ICE-V-Wireless/ICE-V_MfgTest/Hardware/README.md

#Hardware
These directories contain board designs necessary to support the ICE-V Wireless
manufacturing test.
