ICE-V-Wireless/ICE-V_MfgTest/Gateware/README.md

#Gateware
These directories contain gateware necessary to support the ICE-V Wireless
manufacturing test.
