ICE-V-Wireless/ICE-V_MfgTest/Hardware/ICE-V_Test/ICE-V_Test.step

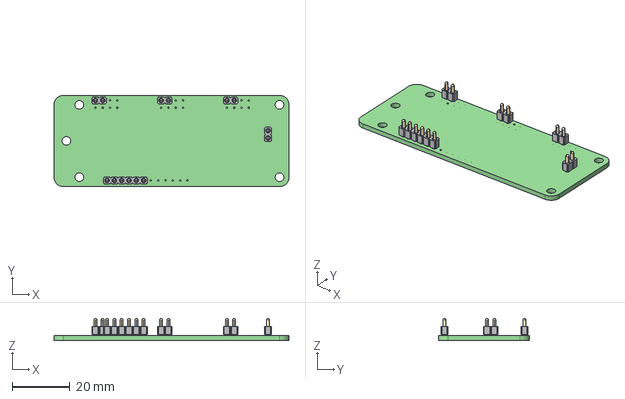
[picture p1: CAD file, 2022-08-24]
Hardware/ICE-V_Test/ICE-V_Test.step
81.7 x 31.8 x 7.75 mm
ICE-V_Test PCB
