ICE-V-Wireless/ICE-V_MfgTest/python/run_test.py

#!/usr/bin/env python3
# Script for the ICE-V Wireless manufacturing testing. This program will
# execute a single pass of the test and firmware load process.

import getopt
import sys
from subprocess import Popen, PIPE, STDOUT, TimeoutExpired
import serial
import re
import time
from os.path import exists
from serial.tools import list_ports
import queue
import threading

# get ESP32C3 serial port
def get_C3_port():
    port = list(list_ports.grep("303a:1001"))
    if len(port) > 0:
        return port[0][0]
    else:
        return 'none'

# strips ANSI escape sequences from received text
def escape_ansi(line):
    ansi_escape =re.compile(r'(\x9B|\x1B\[)[0-?]*[ -\/]*[@-~]')
    return ansi_escape.sub('', line)

# gets output from subprocess into queue for analysis
def output_reader(proc, outq):
    for line in iter(proc.stdout.readline, b''):
        outq.put(line.decode('utf-8'))
    outq.put("Terminated ")
    
# flashes a full set of firmware to the ESP32C3, including SPIFFS
def flash_esp32(port, directory, main, tag, v):
    # run local copy of esptool directly
    cmd = ['../esptool/esptool.py', '-p', port, \
           '-b', '460800', '--before',  'default_reset', '--after', 'hard_reset', \
           '--chip', 'esp32c3', '--no-stub', 'write_flash', '--flash_mode', 'dio', \
           '--flash_size', 'detect', '--flash_freq', '80m', '0x0', \
            directory + '/bootloader.bin', '0x8000', \
            directory + '/partition-table.bin', '0x10000', \
            directory + '/' + main + '.bin',  '0x110000', \
            directory + '/storage.bin']
    p = Popen(cmd, stdout=PIPE, stdin=PIPE, stderr=STDOUT)

    # handle output
    if 0:
        # original batch approach
        output = p.communicate()[0]
        output = output.decode('UTF-8')

        if v:
            print(output)
            
        if "verified" in output:
            print(tag, "Flash Succeeded")
            return 0
        elif "fatal" in output:
            print(tag, "Flash Failed")
            return 1
        else:
            print(tag, "Flash Unknown result")
            return 2
    else:
        # realtime approach needs queues and threads
        result = 2
        q = queue.Queue()
        t = threading.Thread(target=output_reader, args=(p, q))
        t.start()
        time.sleep(0.2)
        running = True
        linectr = 0
        vctr = 0
        fail = False
        while running:
            line = q.get(block=True)
            
            # strip newline
            line = line[:-1]
            linectr = linectr + 1

            # verbose or progress
            if v:
                print(line)
            elif linectr%36==0:
                print(".", end = '')
                sys.stdout.flush()
                
            if "verified" in line:
                vctr = vctr + 1
            elif "fatal" in line:
                fail = True
            elif "Terminated" in line:
                running = False
        t.join()

        print(" ")
        
        if fail:
            print("Flash failed")
            result = 1
        elif vctr == 4:
            print("Flash succeeded")
            result = 0
        else:
            print("Unknown flash result")
        
        return result
    
# run the process
def test_process(port, t, u, i, v):
    err = 0
    if t:
        # flash mfg test firmware
        print("Flashing Mfg Test Firmware...")
        ferr = flash_esp32(port, 'test_firmware', 'ICE-V_MfgTst', \
                           'Test Firmware', v)

        if ferr == False:
            # open up serial port and get test results
            print("Collecting Mfg Test Firmware Results")
            with serial.Serial(port) as tty:
                while True:
                    reply = tty.read_until()
                    rplystr = escape_ansi(reply.decode('utf-8'))
                    rplystr = rplystr.rstrip('\n')
                    rplystr = rplystr[:-1]
                    if "#TEST#" in rplystr:
                        print(rplystr)
                        if "Complete" in rplystr:
                            # test is done so bail out and close port
                            break
                    elif v:
                        print(rplystr)
                        
            # Report result
            if "PASS" in rplystr:
                print("Test Passed")
            elif "FAIL" in rplystr:
                print("Test Failed")
                err = 1
            else:
                print("Test Unknown result")
                err = 1
        else:
            print("Skipped Mfg Test")
        
    if u:
        # flash default end-user firmware
        print("Flashing End-User Firmware...")
        ferr = flash_esp32(port, 'ship_firmware', 'ICE-V_Wireless', \
                           'End-User Firmware', v)
    else:
        ferr = False
    
    if ferr == False and i:
        # try usb-serial command to check ID register
        print("Testing End-User Firmware ID...")
        cmd = ['../../ICE-V-Wireless/python/send_c3usb.py', '-r', '0']

        # Try 5x before giving up
        tries = 0
        ID = "0xb00f0001"
        while tries<5:
            p = Popen(cmd, stdout=PIPE, stdin=PIPE, stderr=STDOUT)

            output = p.communicate()[0]
            output = output.decode('UTF-8')
            output = output[:-1]
            print("Try ", tries, ":", output)
            if ID in output:
                break;
            tries = tries + 1
            time.sleep(0.2)
            
        if ID in output:
            print("USB ID command PASS")
        else:
            print("USB ID command FAIL")
            err = err + 1
            
    # all done
    return err

# usage text for command line
def usage():
    print(sys.argv[0], " [options] Execute Mfg Test & Flashing")
    print("  -h, --help              : this message")
    print("  -p, --port=<tty>        : usb tty of ESP32C3 (default /dev/ttyACM0)")
    print("  -t, --test              : only flash & report mfg test")
    print("  -u, --user              : only flash user firmware")
    print("  -i, --id                : only run ID test on user firmware")
    print("  -v, --verbose           : verbose progress")

# main entry
if __name__ == "__main__":
    try:
        opts, args = getopt.getopt(sys.argv[1:], \
            "hp:tfiuv", \
            ["help", "port=", "test", "user", "id", "verbose"])
    except getopt.GetoptError as err:
        # print help information and exit:
        print(err)  # will print something like "option -a not recognized"
        usage()
        sys.exit(2)

    # defaults
    port = get_C3_port()
    if(port == 'none'):
        print('No ESP32C3 attached')
        sys.exit(2)
    
    t = 1
    u = 1
    i = 1
    v = 0
    
    # scan thru options
    for o, a in opts:
        if o in ("-h", "--help"):
            usage()
            sys.exit()
        elif o in ("-p", "--port"):
            port = a
        elif o in ("-t", "--test"):
            f = 0
            i = 0
        elif o in ("-u", "--user"):
            t = 0
            i = 0
        elif o in ("-i", "--id"):
            t = 0
            u = 0
        elif o in ("-v", "--verbose"):
            v = 1
        else:
            assert False, "unhandled option"

    # check if tty port actually exists
    if exists(port) == False:
        print("Port", port, "does not exist")
        sys.exit(1)

    # run the test
    result = test_process(port, t, u, i, v)
    if result:
        print("Overall - FAIL")
    else:
        print("Overall - PASS")
    
    sys.exit(result)
    
