ICE-V-Wireless/ICE-V_MfgTest/Firmware/ice-v_mfgtest/main/wifi.c

/*
 * wifi.c - part of esp32c3_fpga. Set up pre-provisioned WiFi networking.
 * 04-06-22 E. Brombaugh
 */

#include <string.h>
#include "wifi.h"
#include "esp_event.h"
#include "esp_wifi.h"
#include "esp_wifi_default.h"
#include "esp_netif.h"
#include "nvs_flash.h"
#include "freertos/event_groups.h"
#include "lwip/err.h"
#include "lwip/sys.h"
#include "lwip/sockets.h"
#include "lwip/netdb.h"
#include "phy.h"
#include "credentials.h"
#include "esp_idf_version.h"

static const char *TAG = "wifi";

/******************************************************************************/
/* Basic WiFi connection                                                      */
/******************************************************************************/
static int s_active_interfaces = 0;
#if ESP_IDF_VERSION >= ESP_IDF_VERSION_VAL(5, 0, 0)
static SemaphoreHandle_t s_semph_get_ip_addrs;
#else
static xSemaphoreHandle s_semph_get_ip_addrs;
#endif
static esp_netif_t *s_example_esp_netif = NULL;

#if ESP_IDF_VERSION < ESP_IDF_VERSION_VAL(4, 4, 2)
// there's an include for this in V4.4.2 and beyond
extern void phy_bbpll_en_usb(bool en);
#endif

/* stuff that's usually in the menuconfig */
#define CONFIG_EXAMPLE_WIFI_SCAN_RSSI_THRESHOLD -127
#define EXAMPLE_WIFI_SCAN_METHOD WIFI_ALL_CHANNEL_SCAN
#define EXAMPLE_WIFI_SCAN_AUTH_MODE_THRESHOLD WIFI_AUTH_WPA2_PSK
#define EXAMPLE_WIFI_CONNECT_AP_SORT_METHOD WIFI_CONNECT_AP_BY_SIGNAL
#define NR_OF_IP_ADDRESSES_TO_WAIT_FOR (s_active_interfaces)

esp_netif_t *get_example_netif_from_desc(const char *desc)
{
    esp_netif_t *netif = NULL;
    char *expected_desc;
    asprintf(&expected_desc, "%s: %s", TAG, desc);
    while ((netif = esp_netif_next(netif)) != NULL) {
        if (strcmp(esp_netif_get_desc(netif), expected_desc) == 0) {
            free(expected_desc);
            return netif;
        }
    }
    free(expected_desc);
    return netif;
}

/**
 * @brief Checks the netif description if it contains specified prefix.
 * All netifs created withing common connect component are prefixed with the module TAG,
 * so it returns true if the specified netif is owned by this module
 */
static bool is_our_netif(const char *prefix, esp_netif_t *netif)
{
    return strncmp(prefix, esp_netif_get_desc(netif), strlen(prefix) - 1) == 0;
}

static esp_ip4_addr_t s_ip_addr;

static void on_got_ip(void *arg, esp_event_base_t event_base,
                      int32_t event_id, void *event_data)
{
    ip_event_got_ip_t *event = (ip_event_got_ip_t *)event_data;
    if (!is_our_netif(TAG, event->esp_netif)) {
        ESP_LOGW(TAG, "Got IPv4 from another interface \"%s\": ignored", esp_netif_get_desc(event->esp_netif));
        return;
    }
    ESP_LOGI(TAG, "Got IPv4 event: Interface \"%s\" address: " IPSTR, esp_netif_get_desc(event->esp_netif), IP2STR(&event->ip_info.ip));
    memcpy(&s_ip_addr, &event->ip_info.ip, sizeof(s_ip_addr));
    xSemaphoreGive(s_semph_get_ip_addrs);
}

static void on_wifi_disconnect(void *arg, esp_event_base_t event_base,
                               int32_t event_id, void *event_data)
{
    ESP_LOGI(TAG, "Wi-Fi disconnected, trying to reconnect...");
    esp_err_t err = esp_wifi_connect();
    if (err == ESP_ERR_WIFI_NOT_STARTED) {
        return;
    }
    ESP_ERROR_CHECK(err);
}

static esp_netif_t *wifi_start(void)
{
    char *desc;
    wifi_init_config_t cfg = WIFI_INIT_CONFIG_DEFAULT();
    ESP_ERROR_CHECK(esp_wifi_init(&cfg));

    esp_netif_inherent_config_t esp_netif_config = ESP_NETIF_INHERENT_DEFAULT_WIFI_STA();
    // Prefix the interface description with the module TAG
    // Warning: the interface desc is used in tests to capture actual connection details (IP, gw, mask)
    asprintf(&desc, "%s: %s", TAG, esp_netif_config.if_desc);
    esp_netif_config.if_desc = desc;
    esp_netif_config.route_prio = 128;
    esp_netif_t *netif = esp_netif_create_wifi(WIFI_IF_STA, &esp_netif_config);
    free(desc);
    esp_wifi_set_default_wifi_sta_handlers();

    ESP_ERROR_CHECK(esp_event_handler_register(WIFI_EVENT, WIFI_EVENT_STA_DISCONNECTED, &on_wifi_disconnect, NULL));
    ESP_ERROR_CHECK(esp_event_handler_register(IP_EVENT, IP_EVENT_STA_GOT_IP, &on_got_ip, NULL));

    ESP_ERROR_CHECK(esp_wifi_set_storage(WIFI_STORAGE_RAM));
    wifi_config_t wifi_config = {
        .sta = {
            .ssid = CONFIG_EXAMPLE_WIFI_SSID,
            .password = CONFIG_EXAMPLE_WIFI_PASSWORD,
            .scan_method = EXAMPLE_WIFI_SCAN_METHOD,
            .sort_method = EXAMPLE_WIFI_CONNECT_AP_SORT_METHOD,
            .threshold.rssi = CONFIG_EXAMPLE_WIFI_SCAN_RSSI_THRESHOLD,
            .threshold.authmode = EXAMPLE_WIFI_SCAN_AUTH_MODE_THRESHOLD,
        },
    };
	
	/* spritetm's workaround for auto USB disable - does this work? */
	ESP_LOGI(TAG, "Attempting to re-enable USB");
	phy_bbpll_en_usb(true);

    ESP_LOGI(TAG, "Connecting to %s...", wifi_config.sta.ssid);
    ESP_ERROR_CHECK(esp_wifi_set_mode(WIFI_MODE_STA));
    ESP_ERROR_CHECK(esp_wifi_set_config(WIFI_IF_STA, &wifi_config));
    ESP_ERROR_CHECK(esp_wifi_start());
	
    esp_wifi_connect();

    return netif;
}

static void wifi_stop(void)
{
    esp_netif_t *wifi_netif = get_example_netif_from_desc("sta");
    ESP_ERROR_CHECK(esp_event_handler_unregister(WIFI_EVENT, WIFI_EVENT_STA_DISCONNECTED, &on_wifi_disconnect));
    ESP_ERROR_CHECK(esp_event_handler_unregister(IP_EVENT, IP_EVENT_STA_GOT_IP, &on_got_ip));
    esp_err_t err = esp_wifi_stop();
    if (err == ESP_ERR_WIFI_NOT_INIT) {
        return;
    }
    ESP_ERROR_CHECK(err);
    ESP_ERROR_CHECK(esp_wifi_deinit());
    ESP_ERROR_CHECK(esp_wifi_clear_default_wifi_driver_and_handlers(wifi_netif));
    esp_netif_destroy(wifi_netif);
    s_example_esp_netif = NULL;
}

/* set up connection, Wi-Fi and/or Ethernet */
static void start(void)
{
    s_example_esp_netif = wifi_start();
    s_active_interfaces++;

    /* create semaphore if at least one interface is active */
    s_semph_get_ip_addrs = xSemaphoreCreateCounting(NR_OF_IP_ADDRESSES_TO_WAIT_FOR, 0);
}

/* tear down connection, release resources */
static void stop(void)
{
    wifi_stop();
}

esp_err_t example_connect(void)
{
    if (s_semph_get_ip_addrs != NULL) {
        return ESP_ERR_INVALID_STATE;
    }
    start();
    ESP_ERROR_CHECK(esp_register_shutdown_handler(&stop));
    ESP_LOGI(TAG, "Waiting for IP(s)");
    for (int i = 0; i < NR_OF_IP_ADDRESSES_TO_WAIT_FOR; ++i) {
		/* wait up to 10s then give up so test can complete */
        if(xSemaphoreTake(s_semph_get_ip_addrs, 10000/portTICK_PERIOD_MS) != pdTRUE)
		{
            ESP_LOGW(TAG, "Failed to connect");
			stop();
			return ESP_FAIL;
		}
    }
    // iterate over active interfaces, and print out IPs of "our" netifs
    esp_netif_t *netif = NULL;
    esp_netif_ip_info_t ip;
    for (int i = 0; i < esp_netif_get_nr_of_ifs(); ++i) {
        netif = esp_netif_next(netif);
        if (is_our_netif(TAG, netif)) {
            ESP_LOGI(TAG, "Connected to %s", esp_netif_get_desc(netif));
            ESP_ERROR_CHECK(esp_netif_get_ip_info(netif, &ip));

            ESP_LOGI(TAG, "- IPv4 address: " IPSTR, IP2STR(&ip.ip));
        }
    }
    return ESP_OK;
}

/*
 * initialize the WiFi interface
 */
esp_err_t wifi_init(void)
{
	esp_err_t ret;
	uint8_t cnt = 0;
	
	/* minimum stuff needed for IPV4 WiFi connection */
    ESP_ERROR_CHECK_WITHOUT_ABORT((ret = nvs_flash_init()));
	if(ret) cnt++;
	ESP_ERROR_CHECK_WITHOUT_ABORT((ret = esp_netif_init()));
	if(ret) cnt++;
	ESP_ERROR_CHECK_WITHOUT_ABORT((ret = esp_event_loop_create_default()));
	if(ret) cnt++;
	ESP_ERROR_CHECK_WITHOUT_ABORT((ret = example_connect()));
	if(ret) cnt++;
	
	return cnt == 0 ? ESP_OK : ESP_FAIL;
}

/*
 * get RSSI
 */
int8_t wifi_get_rssi(void)
{
	wifi_ap_record_t ap;
	esp_wifi_sta_get_ap_info(&ap);
	return ap.rssi;
}
