ICE-V-Wireless/ICE-V_MfgTest/Firmware/ice-v_mfgtest/main/adc_c3.c

/*
 * adc_c3.c - ADC driver for ESP32C3
 * 05-18-22 E. Brombaugh
 */
#include "adc_c3.h"
#include "esp_idf_version.h"

static const char* TAG = "adc_c3";

#if ESP_IDF_VERSION < ESP_IDF_VERSION_VAL(5, 0, 0)
/* Legacy ADC driver */
#include "driver/adc.h"
#include "esp_adc_cal.h"

#define ADC_C3_CHL ADC1_CHANNEL_3
#define ADC_EXAMPLE_CALI_SCHEME     ESP_ADC_CAL_VAL_EFUSE_TP
#define ADC_EXAMPLE_ATTEN           ADC_ATTEN_DB_11

static bool adc_c3_cali_enable;
static esp_adc_cal_characteristics_t adc1_chars;

/*
 * from the ESP IDF examples
 */
static bool adc_calibration_init(void)
{
    esp_err_t ret;
    bool cali_enable = false;

    ret = esp_adc_cal_check_efuse(ADC_EXAMPLE_CALI_SCHEME);
    if (ret == ESP_ERR_NOT_SUPPORTED) {
        ESP_LOGW(TAG, "Calibration scheme not supported, skip software calibration");
    } else if (ret == ESP_ERR_INVALID_VERSION) {
        ESP_LOGW(TAG, "eFuse not burnt, skip software calibration");
    } else if (ret == ESP_OK) {
        cali_enable = true;
        esp_adc_cal_characterize(ADC_UNIT_1, ADC_EXAMPLE_ATTEN, ADC_WIDTH_BIT_DEFAULT, 0, &adc1_chars);
    } else {
        ESP_LOGE(TAG, "Invalid arg");
    }

    return cali_enable;
}

/*
 * set up to read a single channel
 */
esp_err_t adc_c3_init(void)
{
	esp_err_t ret;
	uint8_t cnt = 0;
	
    adc_c3_cali_enable = adc_calibration_init();

    ESP_ERROR_CHECK_WITHOUT_ABORT((ret = adc1_config_width(ADC_WIDTH_BIT_DEFAULT)));
    if(ret) cnt++;
	ESP_ERROR_CHECK_WITHOUT_ABORT((ret = adc1_config_channel_atten(ADC_C3_CHL, ADC_EXAMPLE_ATTEN)));
    if(ret) cnt++;

    return cnt == 0 ? ESP_OK : ESP_FAIL;
}

/*
 * read a single channel
 */
int32_t adc_c3_get(void)
{
    int32_t result = adc1_get_raw(ADC_C3_CHL);

    if (adc_c3_cali_enable) {
        result = esp_adc_cal_raw_to_voltage(result, &adc1_chars);
    }
    return result;
}
#else
/* new V5.0 one-shot driver */
#include "esp_adc/adc_oneshot.h"
#include "esp_adc/adc_cali.h"
#include "esp_adc/adc_cali_scheme.h"

#define EXAMPLE_ADC1_CHAN0          ADC_CHANNEL_3

static adc_oneshot_unit_handle_t adc1_handle;
static adc_cali_handle_t adc1_cali_handle = NULL;
static bool do_calibration1;

/*
 * ADC Calibration
 */
static bool example_adc_calibration_init(adc_unit_t unit, adc_atten_t atten, adc_cali_handle_t *out_handle)
{
    adc_cali_handle_t handle = NULL;
    esp_err_t ret = ESP_FAIL;
    bool calibrated = false;

#if ADC_CALI_SCHEME_CURVE_FITTING_SUPPORTED
    if (!calibrated) {
        ESP_LOGI(TAG, "calibration scheme version is %s", "Curve Fitting");
        adc_cali_curve_fitting_config_t cali_config = {
            .unit_id = unit,
            .atten = atten,
            .bitwidth = ADC_BITWIDTH_DEFAULT,
        };
        ret = adc_cali_create_scheme_curve_fitting(&cali_config, &handle);
        if (ret == ESP_OK) {
            calibrated = true;
        }
    }
#endif

#if ADC_CALI_SCHEME_LINE_FITTING_SUPPORTED
    if (!calibrated) {
        ESP_LOGI(TAG, "calibration scheme version is %s", "Line Fitting");
        adc_cali_line_fitting_config_t cali_config = {
            .unit_id = unit,
            .atten = atten,
            .bitwidth = ADC_BITWIDTH_DEFAULT,
        };
        ret = adc_cali_create_scheme_line_fitting(&cali_config, &handle);
        if (ret == ESP_OK) {
            calibrated = true;
        }
    }
#endif

    *out_handle = handle;
    if (ret == ESP_OK) {
        ESP_LOGI(TAG, "Calibration Success");
    } else if (ret == ESP_ERR_NOT_SUPPORTED || !calibrated) {
        ESP_LOGW(TAG, "eFuse not burnt, skip software calibration");
    } else {
        ESP_LOGE(TAG, "Invalid arg or no memory");
    }

    return calibrated;
}

/*
 * set up to read a single channel
 */
esp_err_t adc_c3_init(void)
{
    adc_oneshot_unit_init_cfg_t init_config1 = {
        .unit_id = ADC_UNIT_1,
    };
    ESP_ERROR_CHECK(adc_oneshot_new_unit(&init_config1, &adc1_handle));

    //-------------ADC1 Config---------------//
    adc_oneshot_chan_cfg_t config = {
        .bitwidth = ADC_BITWIDTH_DEFAULT,
        .atten = ADC_ATTEN_DB_11,
    };
    ESP_ERROR_CHECK(adc_oneshot_config_channel(adc1_handle, EXAMPLE_ADC1_CHAN0, &config));

    //-------------ADC1 Calibration Init---------------//
    do_calibration1 = example_adc_calibration_init(ADC_UNIT_1, ADC_ATTEN_DB_11, &adc1_cali_handle);

	return ESP_OK;
}

/*
 * read a single channel
 */
int32_t adc_c3_get(void)
{
	int raw, millivolts;
	
	ESP_ERROR_CHECK(adc_oneshot_read(adc1_handle, EXAMPLE_ADC1_CHAN0, &raw));
	if (do_calibration1) {
		ESP_ERROR_CHECK(adc_cali_raw_to_voltage(adc1_cali_handle, raw, &millivolts));
	}
	
	return millivolts;
}
#endif
