ICE-V-Wireless/ICE-V_MfgTest/Firmware/ice-v_mfgtest/main/mfgtst.h

/*
 * mfgtst.h - definitions for the MFG Test FPGA bitstream
 * 08-02-2022 E. Brombaugh
 */
#ifndef __MFGTST__
#define __MFGTST__

/* ID */
#define MFGTST_ID 0xFEDC3210

/* registers */
#define MFGTST_REG_ID	0
#define MFGTST_REG_PER	1
#define MFGTST_REG_RGB	2
#define MFGTST_REG_GPO	3
#define MFGTST_REG_GPI	4
#define MFGTST_REG_CLK	5

#endif
