ICE-V-Wireless/ICE-V_MfgTest/(commit log)

2022-08-04 initial commit of ICE-V Wireless Mfg Test materials
    [ICE-V_Test.kicad_pcb, ICE-V_Test.kicad_sch, partitions.csv]
2022-08-04 Updated for latest ADC driver
2022-08-24 Start of test jig PCB layout
    Places mill max spring loaded connectors in the appropriate locations.
    Need to update the 3D models for the different variations of the mill max connectors.
    Need to add battery test circuit.
    Mill max connector footprints grafted from butterstick jig design.
    [ICE-V_Test.kicad_pcb, ICE-V_Test.kicad_sch, ICE-V_Test.step]
2022-08-24 Added battery charge test circuit
    [ICE-V_Test.kicad_sch]
2022-08-24 Update PCB with battery charger test circuit
    [ICE-V_Test.kicad_pcb]
2022-08-24 Update step model with battery charger testing components
    [ICE-V_Test.step]
2022-08-27 Added Charge test.
2022-08-30 Add boot button test indicator, wifi pass/fail
    [main.c, run_test.py, wifi.c]
2022-08-31 Clean up, add more error checking, flexible options
    [run_test.py]
2022-08-31 Fix WiFi not connecting when GPIO 8 & 2 high, add some error checking
    [main.c, run_test.py]
2022-09-28 Added bit masking to clean up PMOD errors.
    [main.c]
2022-10-09 Fix button timeout error
    [main.c]
2022-10-11 Adjust charge test bounds for 47uF SMD cap.
2022-10-12 Fix up shebang for more generic operation
    [run_test.py]
2022-10-12 Update charge cycle limits for 3.33Hz +/-1Hz as seen on tester.
